Elektrokrouzek-cz/bluetooth-loudspeaker/doc/module_charger.png

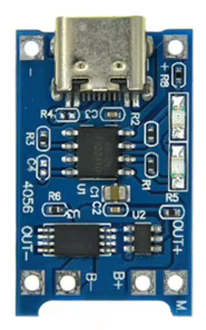
doc/module_charger.png
