Elektrokrouzek-cz/bluetooth-loudspeaker/doc/module_bt_mh-m38.png

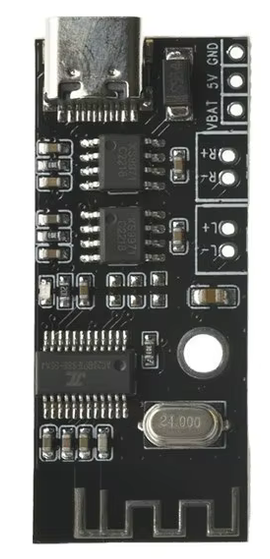
doc/module_bt_mh-m38.png
