Elektrokrouzek-cz/bluetooth-loudspeaker/readme.md

# Bluetooth Loudspeaker
This is a construction of Bluetooth loudspeaker based on two finished modules.

PCB is 2-layer and was designed using KiCad 10. Fabrication output for JLCPCB is in 
gerber folder.

**Happy soldering!**
