Elektrokrouzek-cz/bluetooth-loudspeaker/doc/speaker_40mm.png

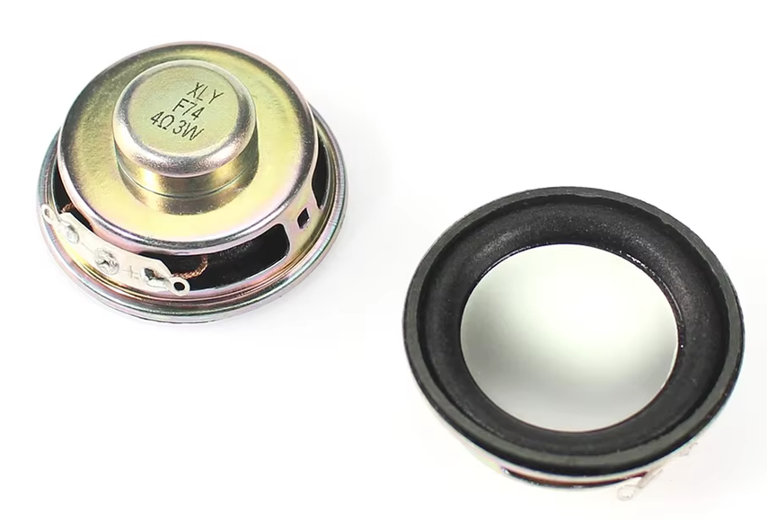
doc/speaker_40mm.png
