Elektrokrouzek-cz/bluetooth-loudspeaker/3d/BT-switch-handle.3mf

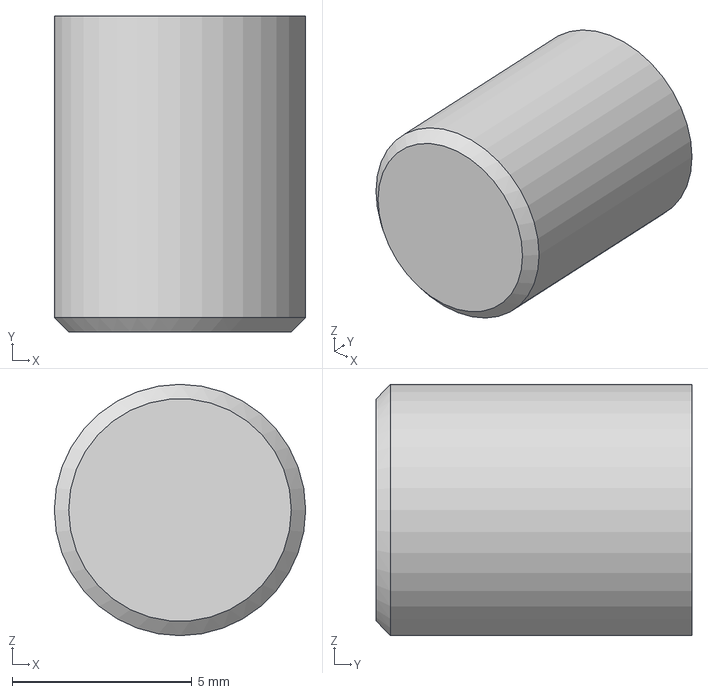
[picture p4: CAD file, 2026-10-22]
3d/BT-switch-handle.3mf
7.00 x 8.80 x 7.00 mm
