Elektrokrouzek-cz/bluetooth-loudspeaker/3d/BT-box.3mf

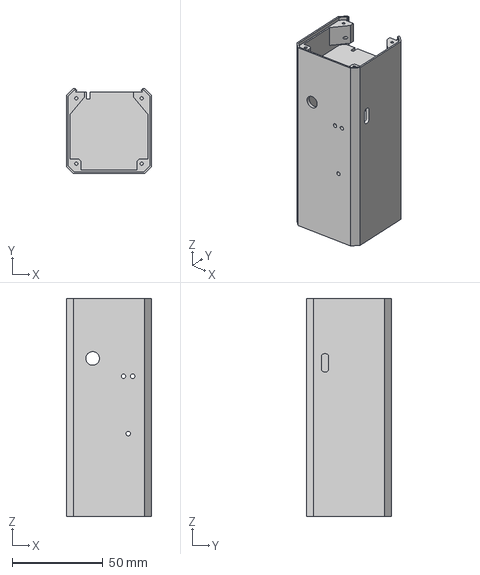
[picture p5: CAD file, 2026-10-22]
3d/BT-box.3mf
47.0 x 47.0 x 120.0 mm
