Elektrokrouzek-cz/bluetooth-loudspeaker/3d/BT-cover.3mf

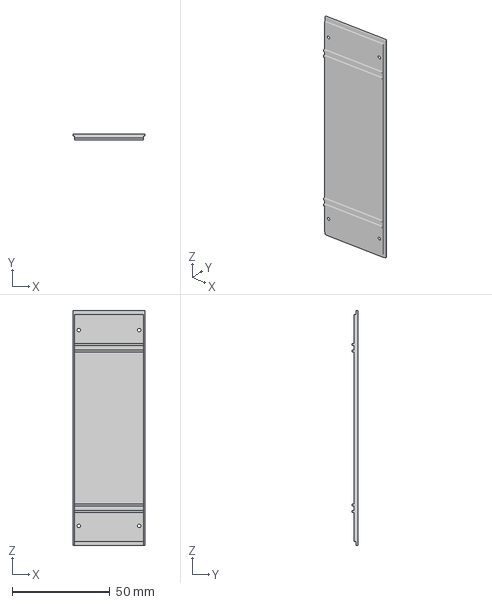
[picture p6: CAD file, 2026-10-22]
3d/BT-cover.3mf
36.8 x 3.00 x 120.0 mm
