Elektrokrouzek-cz/bluetooth-loudspeaker/3d/BT-led-transparent.3mf

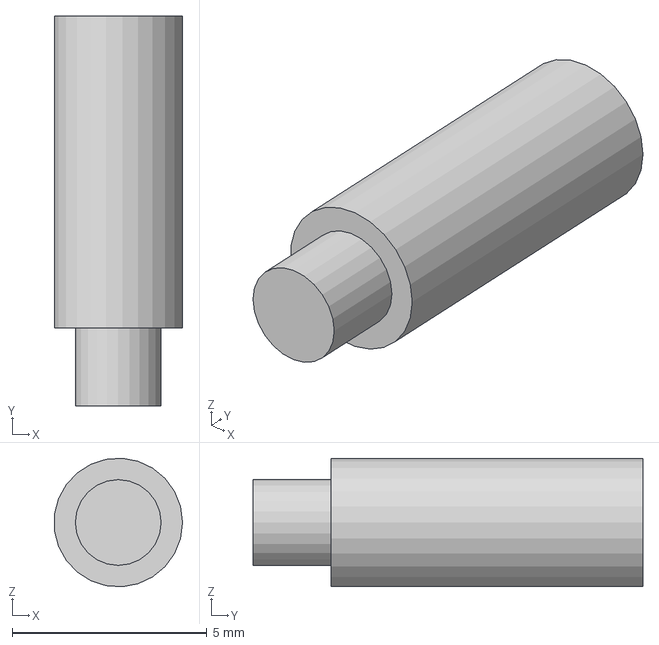
[picture p7: CAD file, 2026-10-22]
3d/BT-led-transparent.3mf
3.29 x 10.0 x 3.29 mm
