Elektrokrouzek-cz/bluetooth-loudspeaker/3d/BT-loudpspeaker-holder.3mf

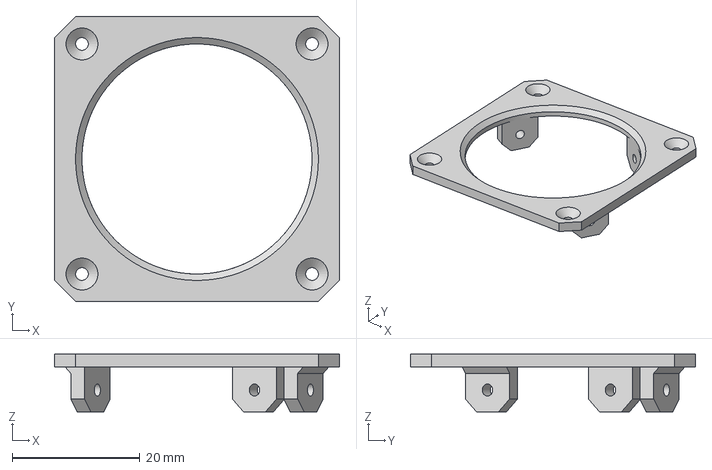
[picture p8: CAD file, 2026-10-22]
3d/BT-loudpspeaker-holder.3mf
44.6 x 44.6 x 9.00 mm
