Elektrokrouzek-cz/bluetooth-loudspeaker/doc/BluetoothSpeaker-Assembly.pdf

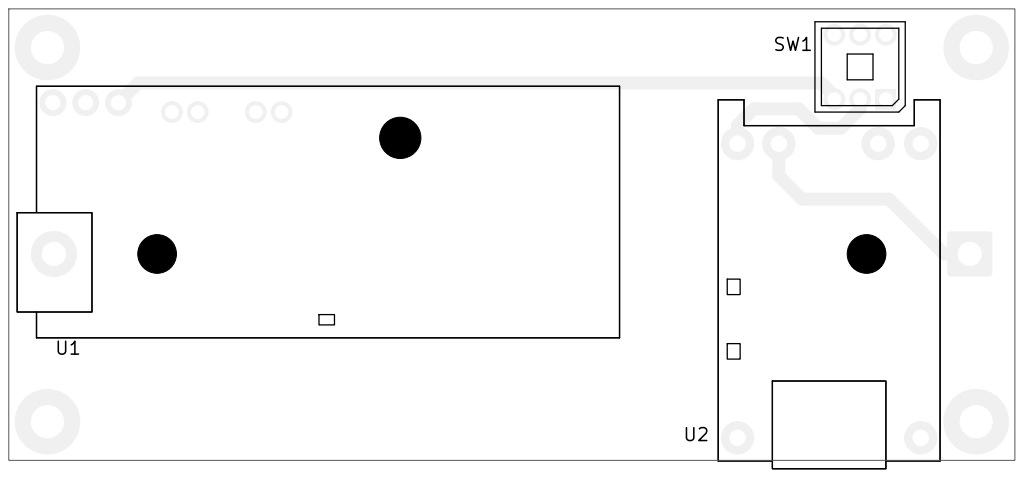
[picture p9: page 1]
D Date:; Size: A4; Rev:

Board2Pdf: Black And White TOP - Page 1/2

Sheet: Black And White TOP
File: bluetooth_speaker.kicad_pcb
Title:
KiCad E.D.A. 10.0.3

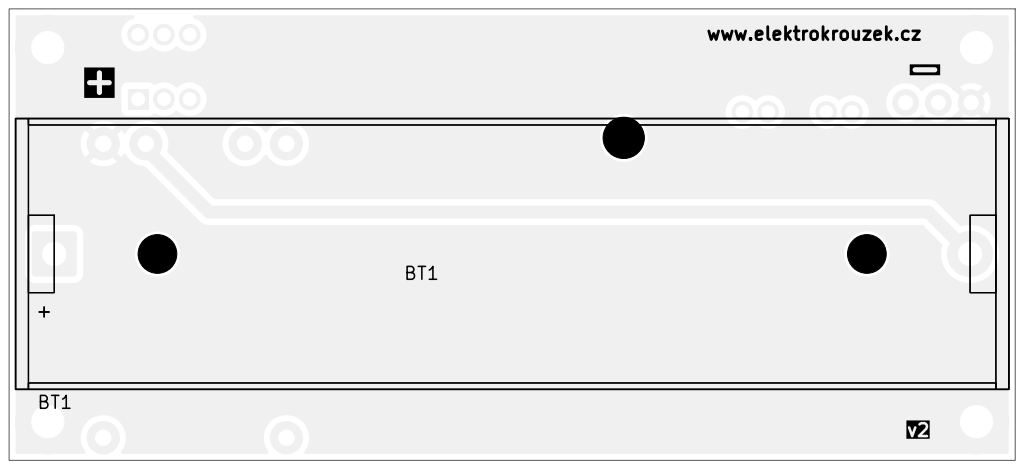
[picture p10: page 2]
D Date:; Size: A4; Rev:

www.elektrokrouzek.cz BT1 +

Board2Pdf: Black And White BOT - Page 2/2

Sheet: Black And White BOT
File: bluetooth_speaker.kicad_pcb
Title:
KiCad E.D.A. 10.0.3
