Elektrokrouzek-cz/bluetooth-loudspeaker/doc/BluetoothSpeaker-Mechanical.pdf

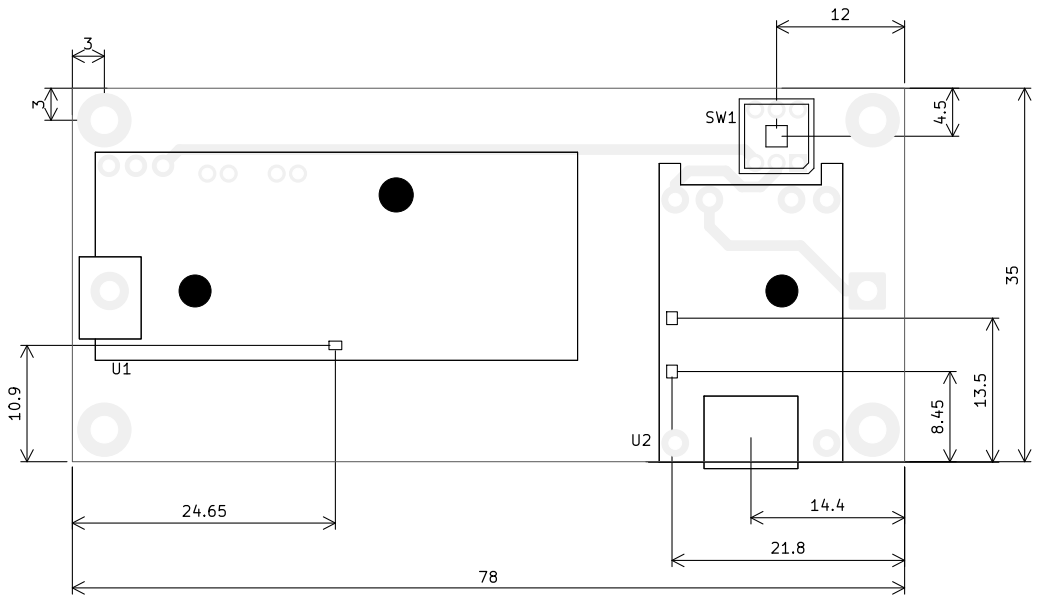
[picture p11: page 1]
D Date:; Size: A4; Rev:

Board2Pdf: Black And White TOP - Page 1/1

Sheet: Black And White TOP
File: bluetooth_speaker.kicad_pcb
Title:
KiCad E.D.A. 10.0.3
