Elektrokrouzek-cz/bluetooth-loudspeaker/doc/BluetoothSpeaker-Schematic.pdf

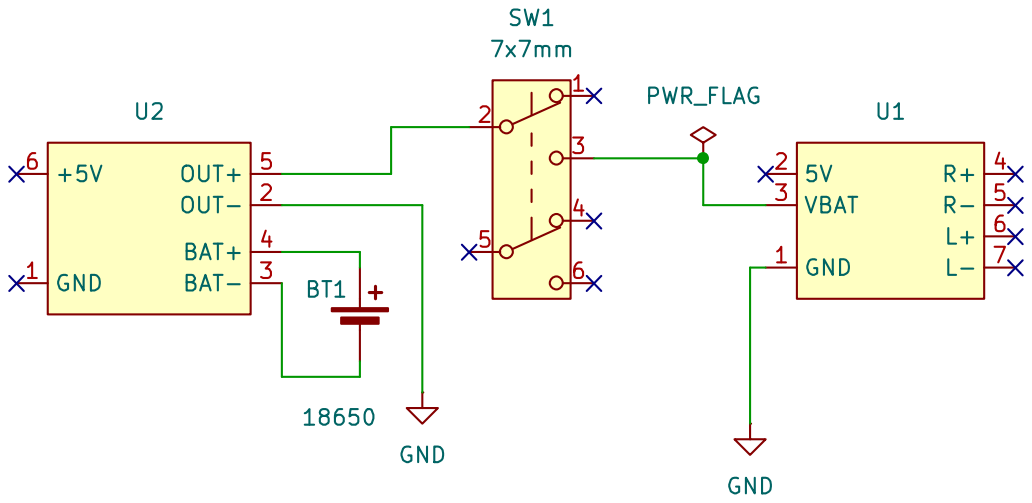
[picture p12: page 1]
