Elektrokrouzek-cz/bluetooth-loudspeaker/kicad/bluetooth_speaker.kicad_pcb

## KiCad design kicad/bluetooth_speaker.kicad_pcb (2026-10-22)

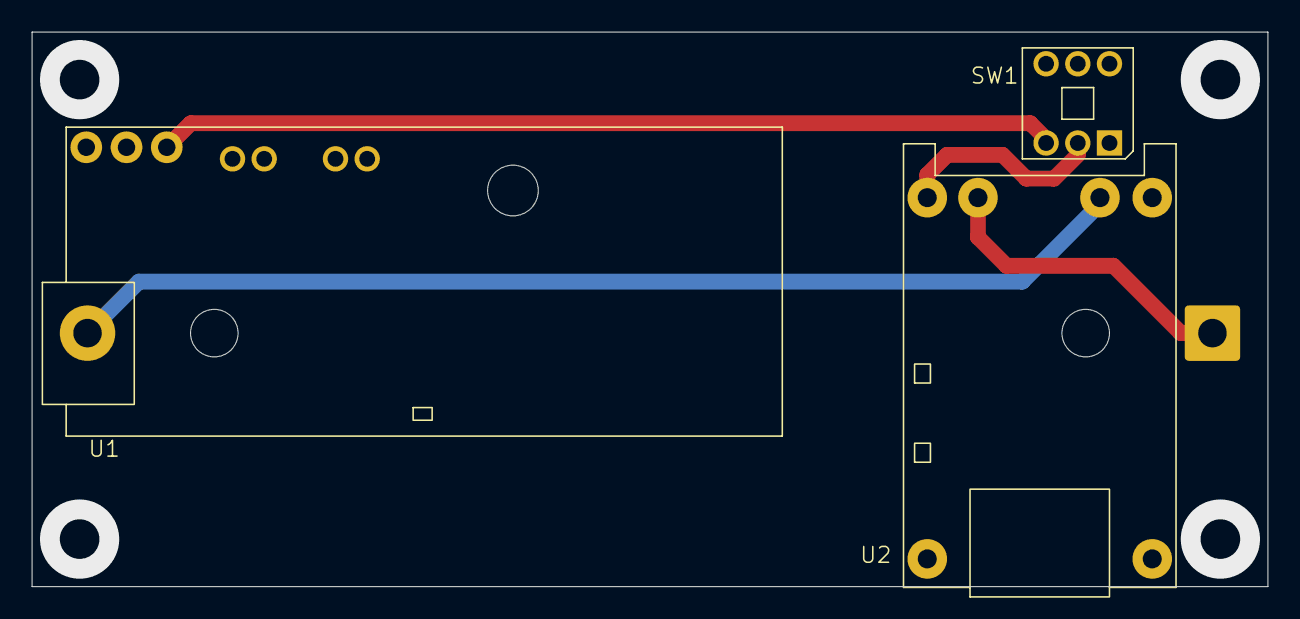
[picture p13: board bluetooth_speaker.kicad_pcb from above]

Board: 2 copper layers, 78.0 x 35.0 mm, 4 parts (1 on the bottom side), 5 nets.

Parts:
BT1: 18650; BatHolder_18650
SW1: 7x7mm; SW_DPDT_7x7_Turbo
U1: Bluetooth_MH-M38
U2: Charger_TP4056

Connections:
GND: U1.1 (GND), U2.2 (OUT-)
unnamed: BT1.1 (+), U2.4 (BAT+)
unnamed: BT1.2 (-), U2.3 (BAT-)
unnamed: SW1.3 (C), U1.3 (VBAT)
unnamed: SW1.2 (B), U2.5 (OUT+)
